gregclacker/FourWheelSteering/original VSC project/documents/Final Presentation/Final Design Presentation.pdf

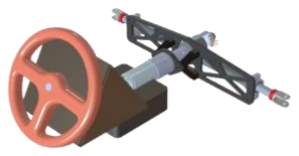
[picture p34: figure]

# Four Wheel Steering

### Adaptive Steering Solution

MAE 4287 Spring 2025

Osama Almasri, Brad Kallam, Samatar Samatar, Tayden Carter, Sarbagnya Bhattarai

Presented 4/25/2025

# Introduction

- Objective
Implement the four-wheel steering system on FSAE race car
- Continuation of previous project group, Quad Steering Solutions
- Electrically driven servo system for rear steer
- Constraints/rules
- 6 degrees of turning
- Integration with existing car, F16

Samatar 1

# Theory

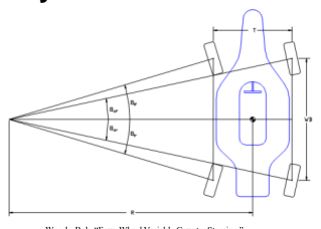
[picture p35: figure]

- Parallel-steering
- All four wheels turn in the same direction
- High speeds
- Counter-steering
- Turn the rear wheels opposite of the front wheels
- Low speed
- This project will only focus on counter-steering
- Small vs large steering inputs

Samatar 2

Woods, Bob, “Four-Wheel Variable Counter Steering,”

# Approach

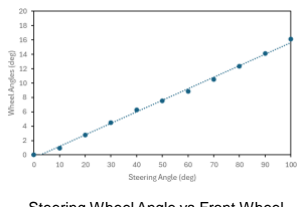
[picture p36: figure]

Turning Radius vs Percentage Rear Steer Equation

Steering Wheel Angle vs Turn Radius Measured from F16

Steering Wheel Angle vs Front Wheel Angle on Car

Bhattarai 3

# Equations

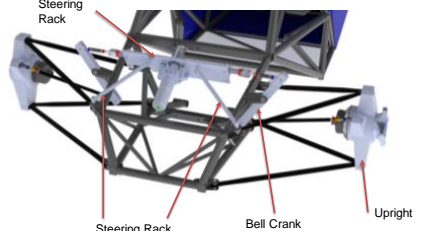
[picture p37: figure]
Rack; Upright

Control System Equations

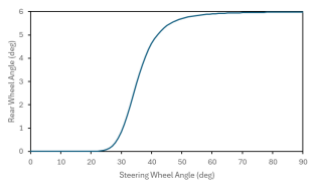
[picture p38: figure]

Theoretical

Turn Radius =

WB
tan(δo)

−

TF
2
12

Measured
Turn Radius = 2231.6 (∅SW)

−1.155

Percentage Rear Steer

PRS = −50 tanh 0.1 Turn Radius − 4.5 + 50

Desired Rear Angle Degrees

∅Desired = PRS × 6.0

Bhattarai 4

# Suspension Modifications

Almasri 5

Steering

Steering Rack
Chassis Mounts

Bell Crank

1 | 2
3 | 4
5 | 6

# Suspension Modifications

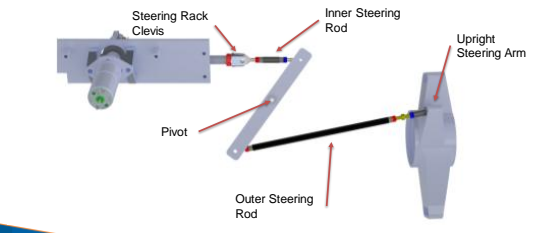
[picture p39: figure]
Steering Rack Clevis; Pivot; Outer Steering Rod; Upright Steering Arm; Inner Steering Rod

Almasri 6

# Suspension Modifications

Almasri 7

# System Testbed

Includes:
- Steering Rack
- Servo Motor
- Control Components
- Electronics Board
- Steering wheel mounted to potentiometer for user input

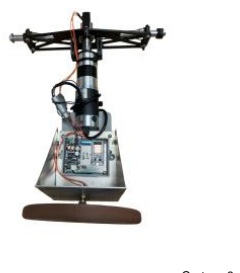
[picture p40: figure]
Steering Rack; Potentiometer; Servo Motor; Electronics Board; Steering Wheel

Carter 8

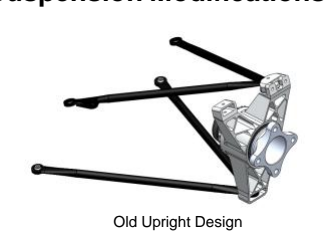
[picture p41: figure]
New Upright Design Old Upright Design

# Control Component - Electronics

- ESP32 Microcontroller for its
processing speed.
- Sealed connectors and housing for automotive use
- Ready to install on F16

ESP32
Microcontroller

MD13S Motor
Driver

Potentiometer
Terminal Block

Carter 9

# Control Components

- Front steering position sensor
- Input to Control System
- Mounts to existing F16 front steering rack input shaft
- Determines desired rear steering position

### Desired Rear Steer Position

Steering shaft
interface

Front
potentiometer

Clamshell-type rack
interface

Kallam 10

# Control Components

### Actual Rear Steer Position

- Actual rear steering position determined using second
potentiometer

Rear

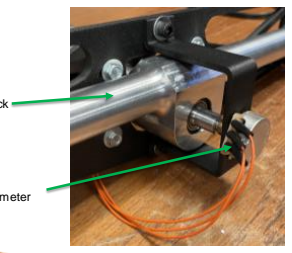
[picture p42: figure]

Potentiometer

Rear Steering Rack

Kallam 11

7 | 8
9 | 10
11 | 12

# Testbed Demonstration

# Questions?

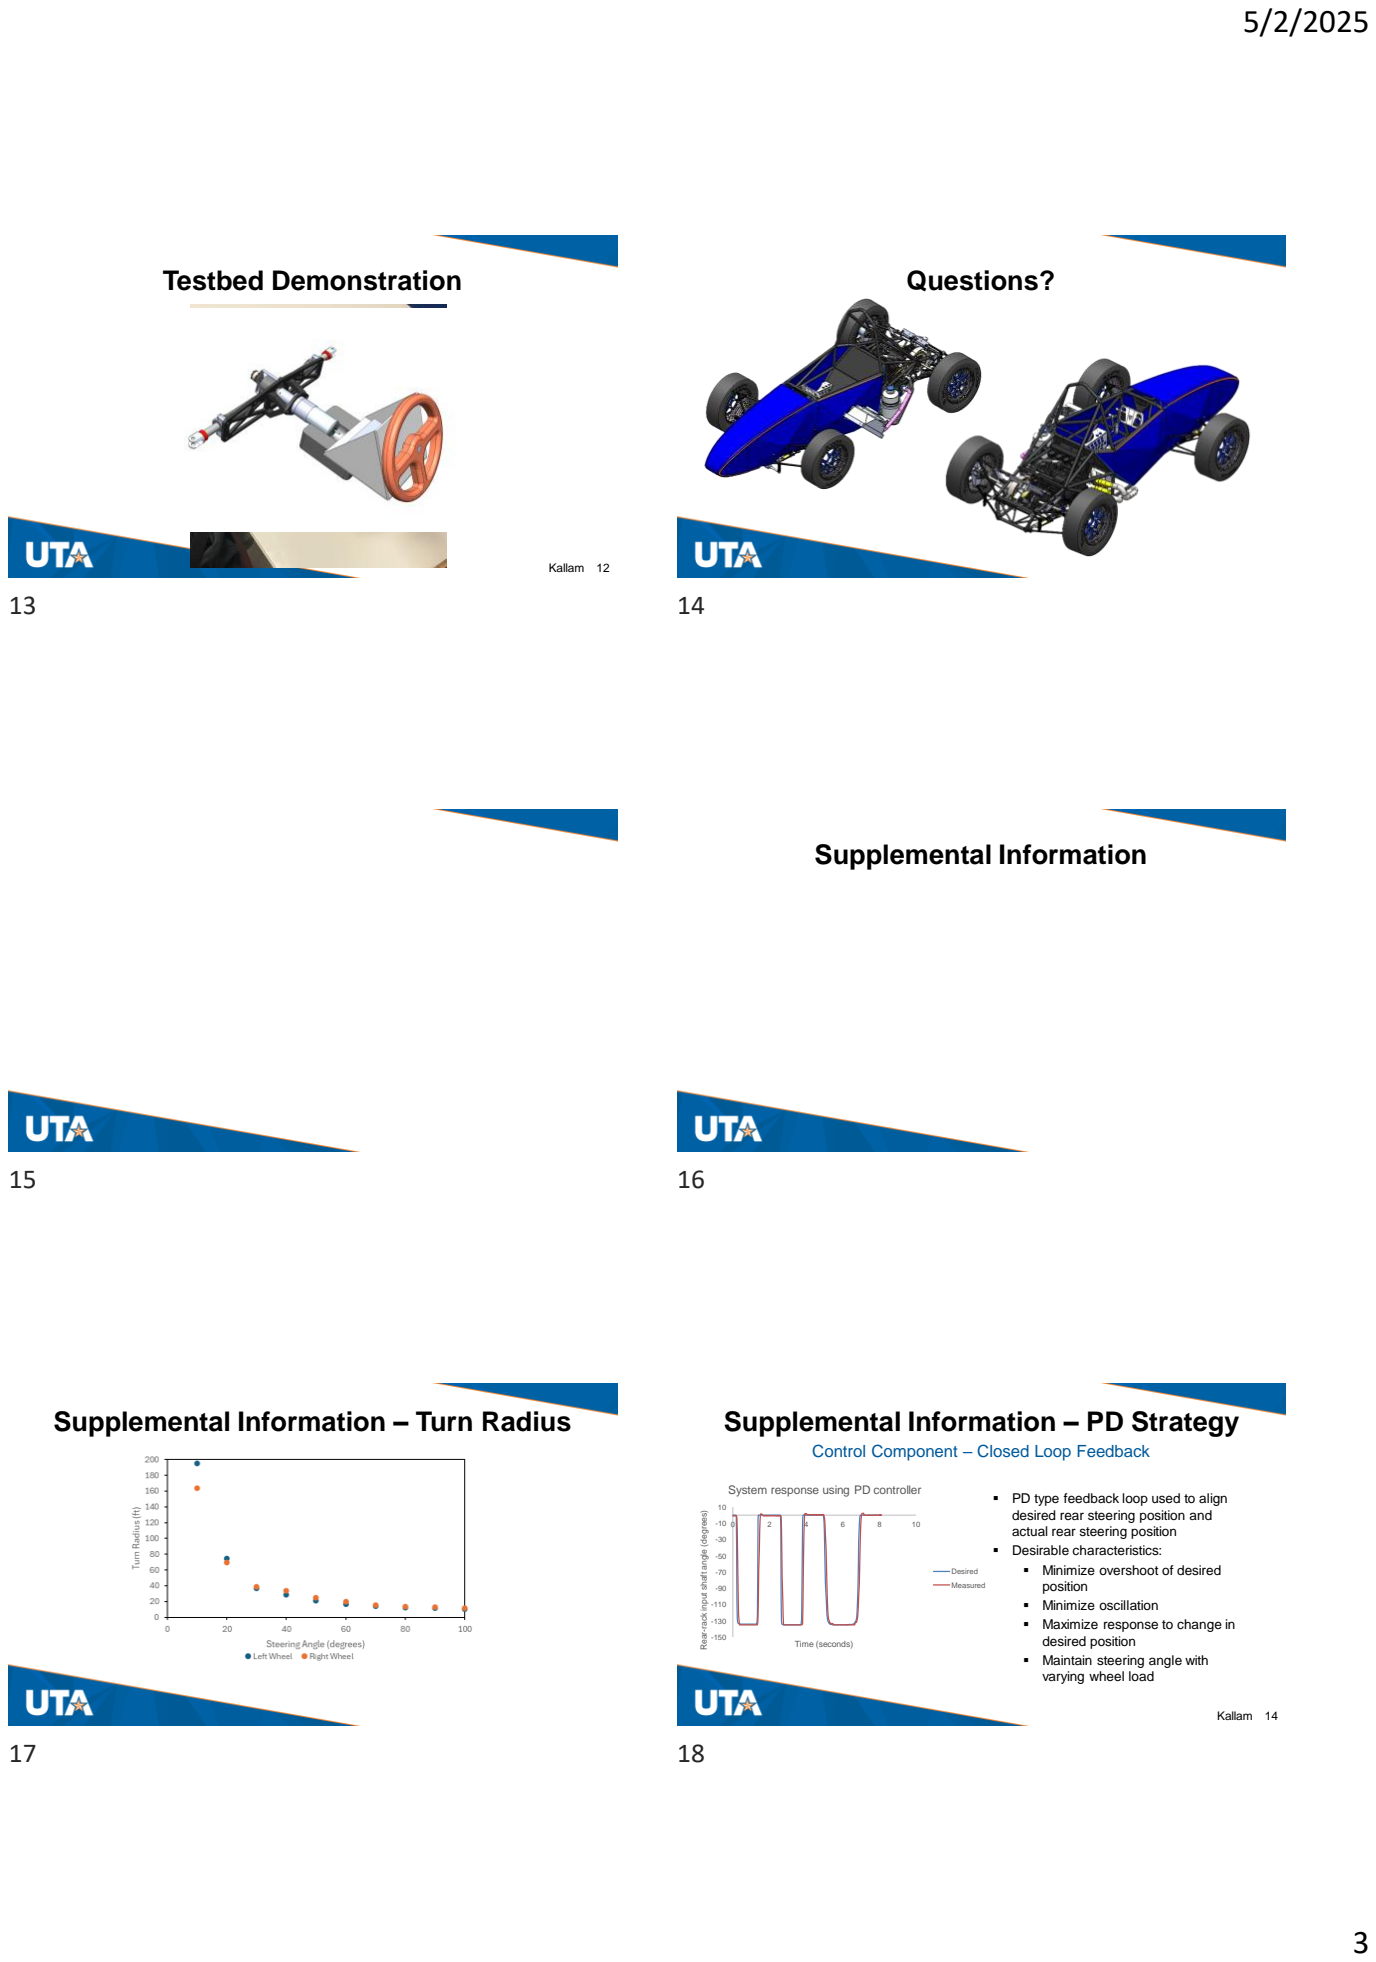
[picture p43: page 3]
Kallam 12; Supplemental Information; Supplemental Information – Turn Radius; Supplemental Information – PD Strategy; Time (seconds); Desired; Measured; Kallam 14

Control Component – Closed Loop Feedback

System response using PD controller

▪ PD type feedback loop used to align
desired rear steering position and
actual rear steering position
▪ Desirable characteristics:
▪ Minimize overshoot of desired
position
▪ Minimize oscillation
▪ Maximize response to change in
desired position
▪ Maintain steering angle with
varying wheel load

Rear-rack input shaft angle (degrees)

# Supplemental Information - Code

- The code was designed to be easily adjusted and adaptable for future

implementation.

- Wrote in C as it is a pre-compiled language meaning faster computing speed and

more control over the memory and hardware

- The measured values for the car are stored as variables therefore when changes are

made the code is quick to adjust

Source:TireRack

Camber Angle | Caster Angle

Toe Angle

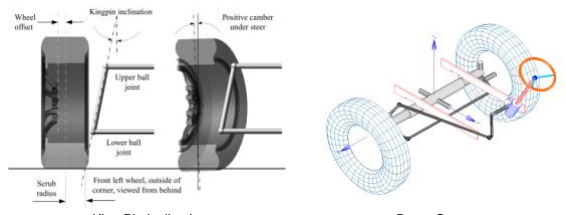
[picture p44: figure]

King Pin Inclination | Bump Steer

Source: wikimedia commons

# Reference

- [1]. Woods, Bob, “Four-Wheel Variable Counter Steering,” February 20, 2022, UTA Internal Documentation, file: “Four-Wheel Variable Counter Steering.docx”
19 | 20
21 | 22
