gregclacker/FourWheelSteering/original VSC project/documents/Final Presentation/Presentation guidelines.docx

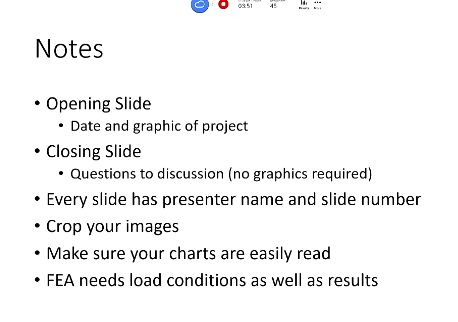
[picture p45: figure]

One presenter on a slide; use team on multi person slide but avoid this where possible

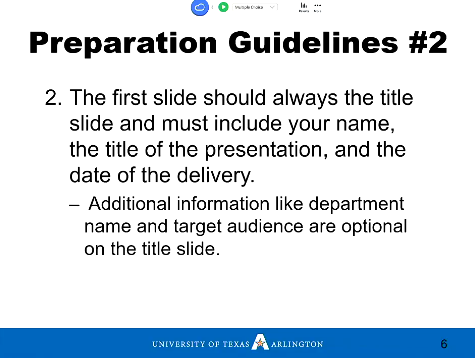
[picture p46: figure]
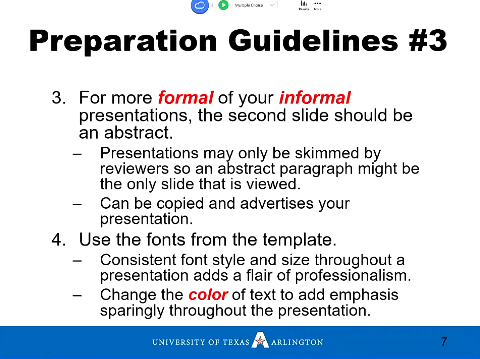
[picture p47: figure]
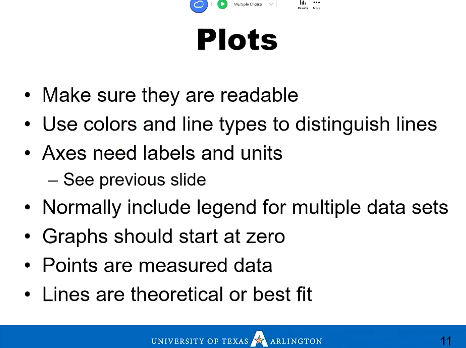
[picture p48: figure]
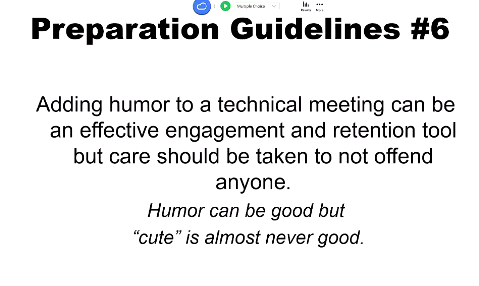
[picture p49: figure]
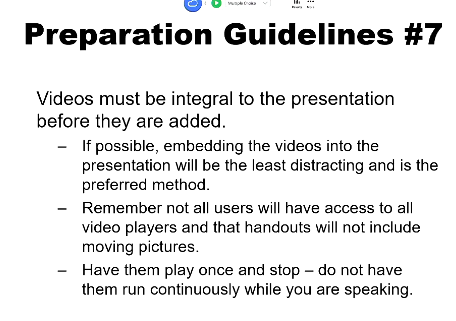
[picture p50: figure]
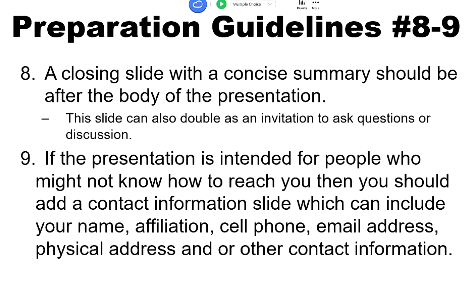
[picture p51: figure]
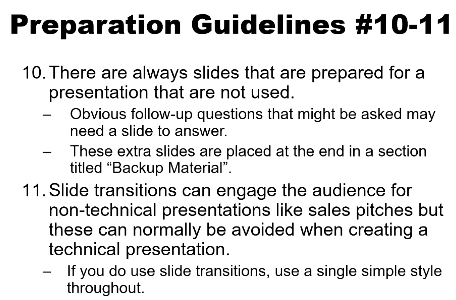
[picture p52: figure]
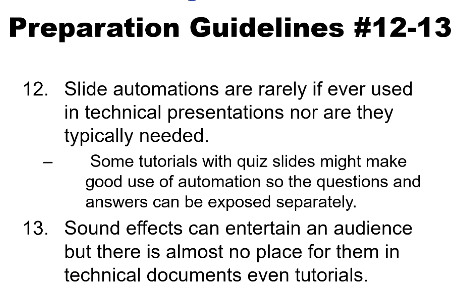
[picture p53: figure]
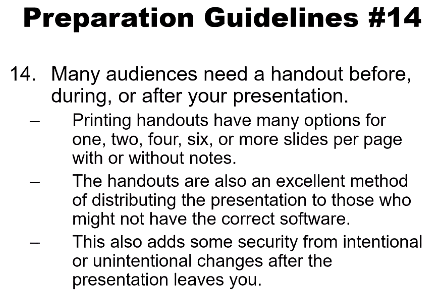
[picture p54: figure]
