gregclacker/FourWheelSteering/original VSC project/main/RearAngle.h

#ifndef REARANGLE_H
#define REARANGLE_H

#define RS_WA_LW_SLOPE  0.0f
#define RS_WA_LW_INTERCEPT  0.0f
#define RS_WA_RW_SLOPE  0.0f
#define RS_WA_RW_INTERCEPT  0.0f    
#define RS_TR_LW_COEFFICIENT    0.0f  
#define RS_TR_LW_POWER  0.0f    
#define RS_TR_RW_COEFFICIENT    0.0f
#define RS_TR_RW_POWER  0.0f

#endif
