gregclacker/FourWheelSteering/original VSC project/main/pwm.h

#ifndef PWM_H
#define PWM_H

//PWM Values
#define PWM_FREQ 1500
#define LEDC_TIMER_13_BIT 13
#define PWM_RESOLUTION 13
#define PWM_MAX_DUTY (1 << 13)

#endif
