gregclacker/FourWheelSteering/(commit log)

2025-04-05 Removed the error limiting
    [main.c]
2025-04-07 PID Tuning
2025-10-01 blurb
    retuned the PID. also this project setup sucks. dont ever use VScode for this kind of stuff without instrucitons for how to set it up
2025-10-02 pwm not quite owrking
2025-10-07 KiCAD Stuff
    scjsdck
    [FourWheelSteering.kicad_pcb, FourWheelSteering.kicad_sch]
2025-10-09 Updated KiCAD symbols and footprints for MSPM1306
    SDFAGD
    [FourWheelSteering.kicad_sch]
2025-10-22 | 10-21-25 | Setup ADC and motor_dir Functionality |
2025-10-23 Finished setting up UART output (Doesn't work tho)
    [main.cpp]
2025-10-24 10-23-25 - Tried Fixing ADC Output (Kinda works)
    [main.cpp]
