gregclacker/FourWheelSteering/original VSC project/documents/Final Presentation/Pictures/Rear Steering Pot.jpg

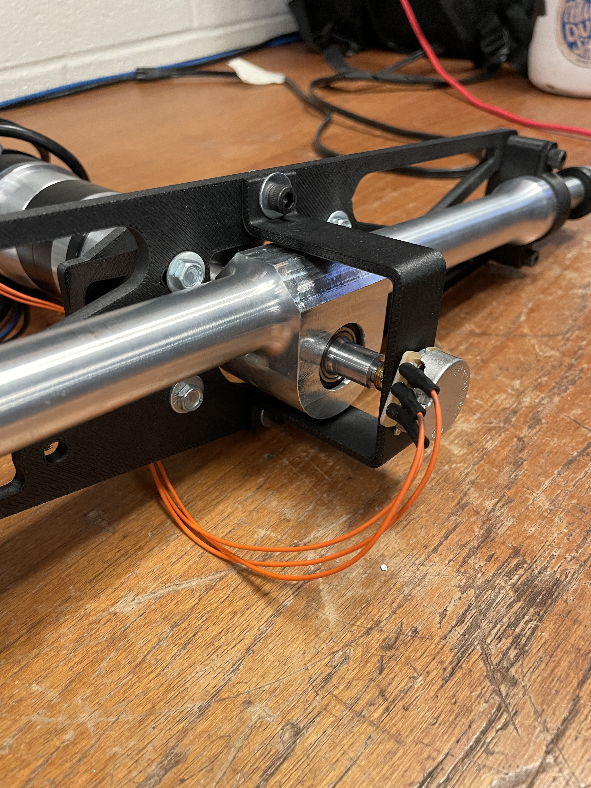
original VSC project/documents/Final Presentation/Pictures/Rear Steering Pot.jpg
